GhimirePlan/Project_AuraSync/Documentations/AuraSync_Final_Defense.pdf

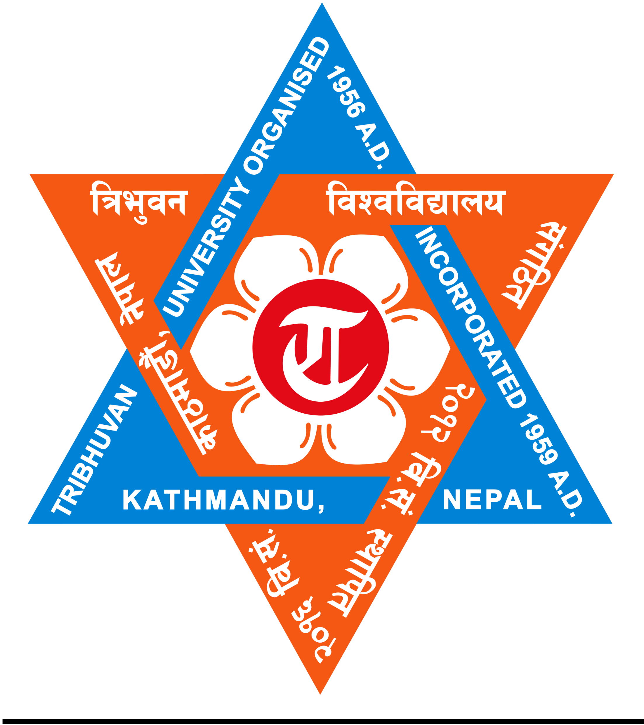
[picture p2: figure]

### Department of Electronics and Computer Engineering

### Institute of Engineering, Thapathali Campus

## A PRIVACY-PRESERVING EDGE TINYML SYSTEM FOR ACOUSTIC COMFORT ESTIMATION USING HYBRID DSP-CNN FUSION AND VISUAL FEEDBACK

## Team Members:

Plan Ghimire (080BEI028)
Pranjal Shrestha (080BEI033) Sagun Acharya (080BEI037)

Samman Ghale (080BEI039)

## Supervised By:

Dr. Binod Sapkota

Final Defense Presentation | August, 2026

# Presentation Outline

## 1. Motivation and Problem

## 2. Objectives

## 3. Scope and Applications

## 4. Literature Review

## 5. System Methodology

## 6. TinyML Development

## 7. Results and Validation

## 8. Privacy Boundary

## 9. Future Enhancements

## 10. Conclusion

August, 2026 | 2

# Motivation: Acoustic Comfort Needs Intelligence

## Current problem

### - Conversations and activities increase

noise.

### - Sound meters need people to keep

checking them.

### - Loud alarms can disturb the

environment further.

### - Direct warnings can make people feel

uncomfortable.

## Proposed response

- Monitor the sound level continuously.

### - Identify speech and other noise

activities.
- Give simple and calm visual feedback.

### - Help people control their noise

naturally.

### SENSE −→ INTERPRET −→ RESPOND

Goal: self-regulating shared spaces through objective visual feedback.

# Objectives

## Main Objective

## Design, develop, and validate a privacy-preserving edge acoustic-comfort

indicator using hybrid digital signal processing and embedded deep learning.

## Secondary Objectives

- Measure ambient sound levels and extract acoustic features in real time.

## - Classify stationary background, speech-dominant, and non-speech activity

using a TinyML CNN.
- Fuse deterministic DSP metrics with probabilistic model predictions.
- Provide adaptive visual feedback and anonymous dashboard analytics.

# Scope and System Boundary

## Included

## - Capture sound at 16 kHz

## - Measure sound level and key features

## - Classify sounds using INT8

## DS-CNN

## - Combine results to determine noise state

- Show feedback on TFT, LEDs,

## and dashboard

## Boundaries

- Raw audio is never stored or sent.

## - The prototype is an acoustic-comfort indicator, not a

certified legal sound-level meter.

## - Dashboard needs a local Wi-Fi

connection.

## - Secure MQTT communication is

future work.

# Project Applications

01
Classrooms

02
Libraries

03
Study rooms

04
Laboratories

05
Shared offices

06
Collaborative zones

# Literature Review and Research Gap

Prior work | Approach | Key finding | Gap addressed
IoT noise monitoring | dBA sensing and Wi-Fi dashboard | Live monitoring and logging | Adds sound-type awareness and local intelligence
TinyML anomaly detection | On-device inference | Low latency and low power | Adds stable and interpretable comfort states
Irrelevant-speech studies | Laboratory cognition experiments | Speech increases cognitive ef- fort | Converts findings into practical feedback
Large-scale audio CNNs | YAMNet/AudioSet classification | Strong audio representations | Distills knowledge into an MCU- ready DS-CNN

## Research Gap

Prior systems rarely combine calibrated DSP, TinyML classification, stable state logic, local privacy, and visual feedback in one low-cost embedded device.

# Methodology - [1] Overall System Block Diagram

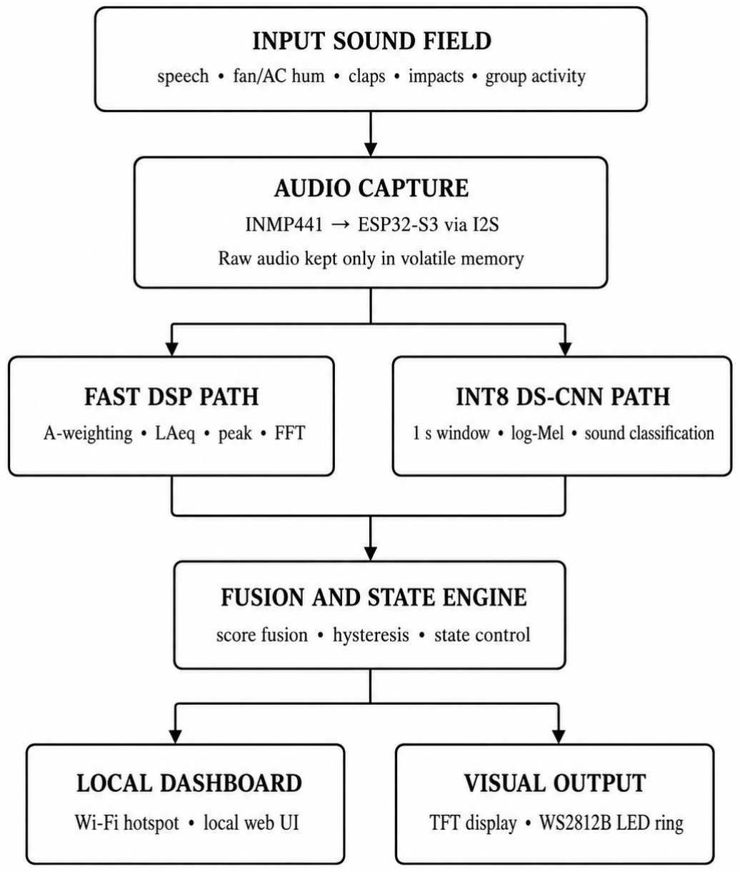
[picture p3: figure]

# Methodology - [2] Core Hardware Components

## ESP32-S3 N16R8

Core: dual-core 240 MHz Xtensa LX7.

### Memory: 16 MB flash and 8 MB

PSRAM.
Role: real-time DSP, INT8 inference, state control, display, and web service.

## INMP441 I2S MEMS Microphone

### Type: omnidirectional 24-bit digital

microphone.
Interface: I2S digital audio.

### Role: 16 kHz mono capture without an

analog conversion stage.

## Why this pair?

### Digital I2S acquisition reduces analog noise, while the ESP32-S3 provides enough

compute and memory for parallel DSP, TinyML, and local visualization.

# Methodology - [3] Feedback and Power Hardware

## 1.8-inch TFT SPI Display

Interface: high-speed SPI.
Role: displays live disturbance state, dBA level, score, and system status.

## WS2812B RGB LED Strip

Type: individually addressable LEDs.

### Role: immediate ambient feedback through state-specific colors and ani-

mations.

## Supporting hardware

### - TP4056 charging/protection module - 18650 Li-ion battery supply

## Physical integration

### - Compact 3D enclosure - Separated sensor/display placement

# Methodology - [4] Firmware and On-Device Software

### Firmware and execution

### - Arduino IDE and ESP32 toolchain

### - FreeRTOS tasks and dual-core scheduling

### - I2S DMA audio acquisition

### - Ucglib TFT rendering and LED control

### On-device processing

### - ESP-DSP FFT and biquad filtering

### - TensorFlow Lite for Microcontrollers

### - Fully quantized INT8 inference

### - Local HTTP/JSON status service

## Scheduling principle

### Fast DSP updates every 100 ms; one-second CNN inference does not block the feedback

loop.

# Methodology - [5] Offline AI and Dashboard

# Stack

### Offline AI pipeline

### - Python, TensorFlow, Keras, and Librosa

### - Audio preprocessing and embeddings

### - Teacher-student knowledge distillation

### - DS-CNN training and INT8

### quantization

### Visualization

### - HTML5 Canvas and JavaScript

### - Board-hosted responsive dashboard

### - Asynchronous HTTP polling

### - Anonymous scalar metrics only

Training occurs offline; operational inference occurs entirely on the edge device.

# Methodology - [6] Audio Capture and DSP

# Pipeline

### - 16 kHz mono audio capture

using INMP441 and I2S DMA.

### - Temporary PCM storage in an

SRAM ring buffer.

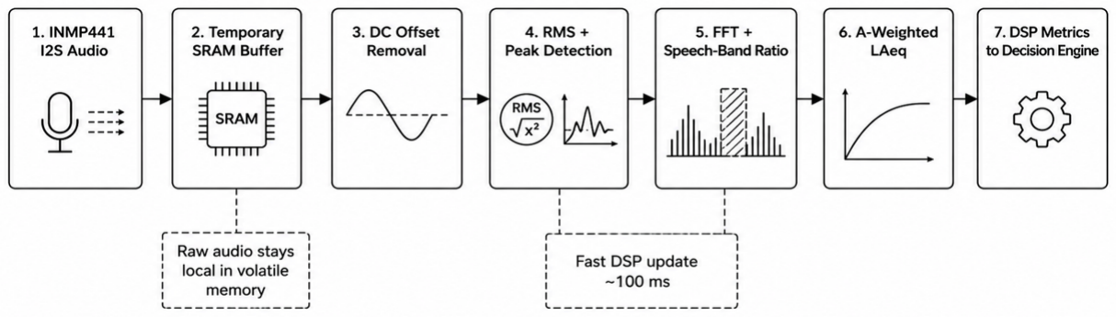
[picture p4: figure]

- DC offset removal, windowing, RMS and peak calculation.

### - FFT analysis for speech-band

ratio and spectral flux.

### - A-weighting and calibration for

LAeq estimation.

# Methodology - [7] Fast DSP Path

## Update cadence

100 ms

### 1,600 samples per block at 16 kHz

## Physical acoustic features - A-weighted LAeq

## - Peak, RMS, and crest factor

## - 256-point FFT

## - Speech-band energy ratio

## - Spectral flux and spike evidence

Purpose: fast, deterministic reaction to loudness and transient events.

# Methodology - [8] Log-Mel and TinyML Path

## Inference window

# 1 s

### 16,000 samples, updated continuously

## Feature tensor construction - 512-point FFT with 320-sample hop

## - 64 Mel filter-bank channels

## - Log compression and normalization

## - 49 × 64 × 1 input tensor

## - Three-class INT8 DS-CNN inference

Purpose: identify acoustic context that loudness alone cannot explain.

# Methodology - [9] Teacher-Student Model Training

## 1. Transfer learning

### - Reuse a model trained on a large audio

dataset.

### - Adapt learned representations to

three project classes.

## 2. YAMNet teacher

### - Frozen MobileNetV1-based

audio classifier.

### - Produces 1,024-D embeddings and soft

targets.

## 3. DS-CNN student

- Fast and lightweight;

### optimized for

microcontrollers.

### - Uses depthwise separable

convolutions.

## Knowledge Distillation

YAMNet is too large for microcontrollers. Knowledge Distillation trains a compact Student model to match the soft probability outputs of a heavy Teacher model. This compresses deep-learning intelligence so it can run directly on the ESP32-S3.

# Methodology - [10] Teacher-Student DS-CNN Architecture

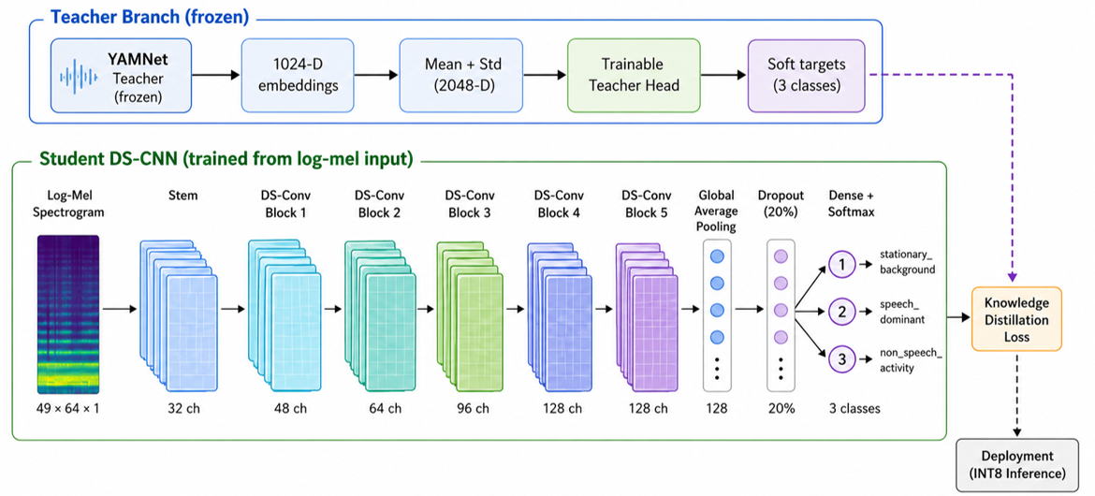
[picture p5: figure]

### - Multiple student configurations were evaluated during training; the model with the

lowest Knowledge Distillation loss was deployed on the ESP32-S3.

# Methodology - [11] Dataset Overview

## Dataset preparation

## - Collected 12,466 environmental audio clips

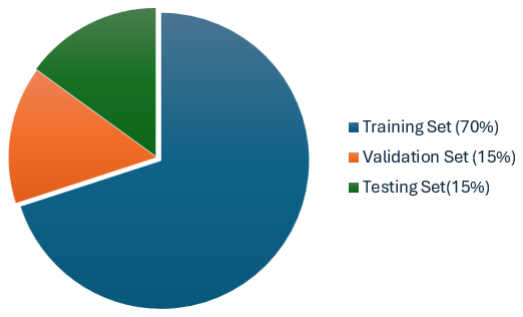
[picture p6: figure]

## - Each clip is 1 second long, sampled at 16

## kHz

## Three audio classes:

## - Stationary Background

### (fan, AC, computer hum, quiet room)

## - Speech Dominant

### (conversations, discussions, lectures)

## - Non-Speech Activity

### (typing, footsteps, coughing, clapping)

## Dataset Split

# Methodology - [12] Fused Disturbance Score

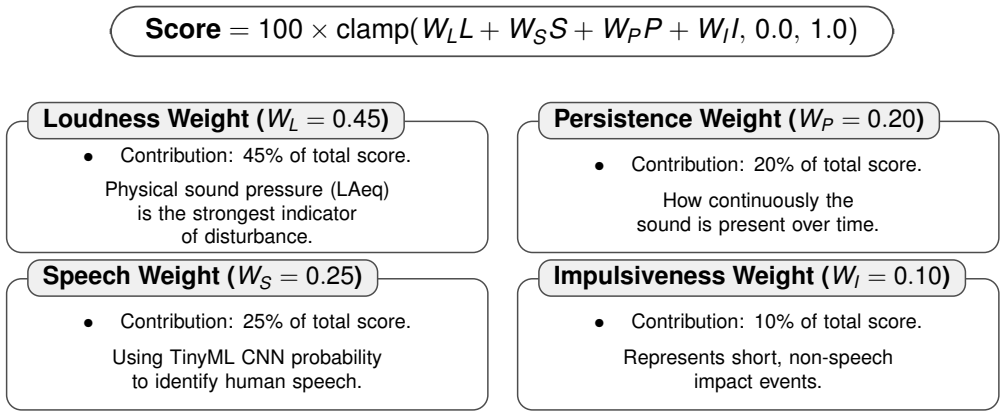
[picture p7: figure]
Loudness Weight (WL = 0.45); • Contribution: 45% of total score.; Physical sound pressure (LAeq) is the strongest indicator of disturbance.; Persistence Weight (WP = 0.20); • Contribution: 20% of total score.; How continuously the sound is present over time.; Speech Weight (WS = 0.25); • Contribution: 25% of total score.; Using TinyML CNN probability to identify human speech.; Impulsiveness Weight (WI = 0.10); • Contribution: 10% of total score.; Represents short, non-speech impact events.

## Score = 100 × clamp(WLL + WSS + WPP + WI

# Methodology - [13] State Machine Architecture

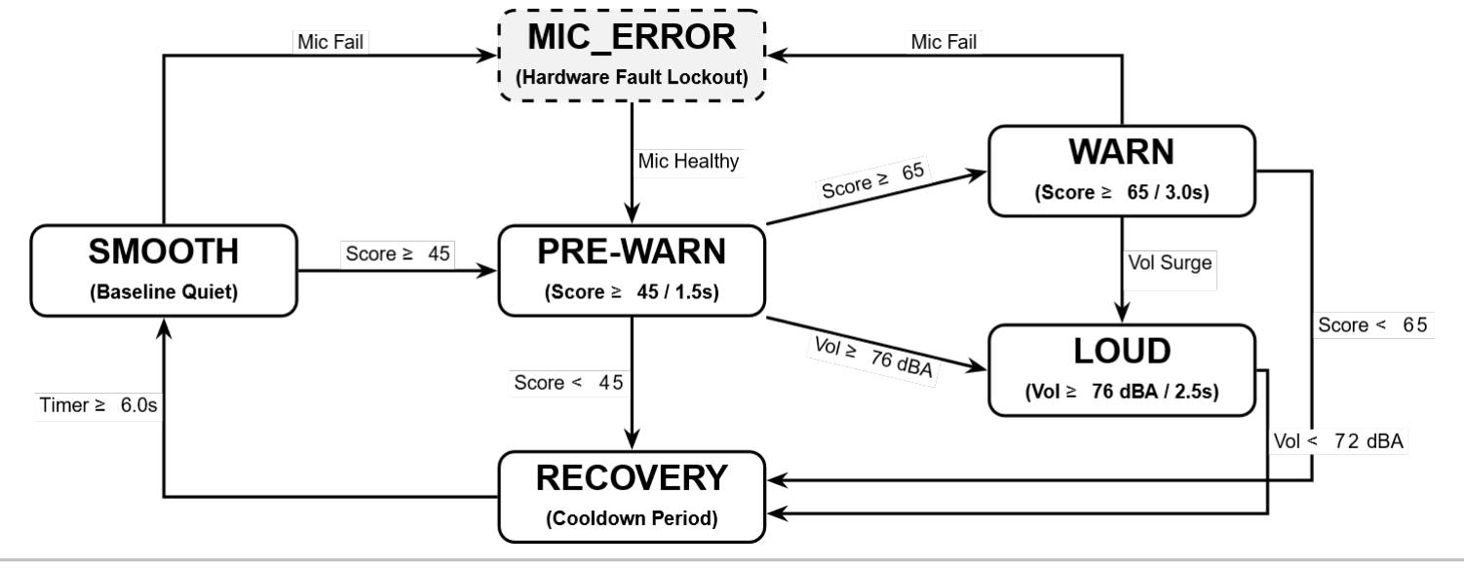
[picture p8: figure]

State & Threshold Calibration :
- 4 states: SMOOTH → PRE-WARNING → WARNING → LOUD
- Thresholds are tested using measured audio and reference sound-level meter.
- ISO 22955:2021 / ANSI/ASA S12.60 used as acoustic-comfort references.
- Thresholds tuned for stable transitions and fewer false alarms.

# Results - [1] Model Performance

### Test Set Confusion Matrix Comparison (1,876 Samples)

Float32 Baseline (Before)

True \ Pred | BG | Speech | Non-Sp
Background | 323 | 3 | 89
Speech | 4 | 492 | 16
Non-Speech | 68 | 12 | 869

Full INT8 Model (Deployed)

True \ Pred | BG | Speech | Non-Sp
Background | 324 | 4 | 87
Speech | 4 | 493 | 15
Non-Speech | 69 | 12 | 868

## Quantization Impact

Full INT8 post-training quantization preserves decision boundaries across all three classes with negligible impact on accuracy (89.77% → 89.82%) while reducing model memory footprint to 75.6 KiB.

# Results - [2] Local Web Dashboard

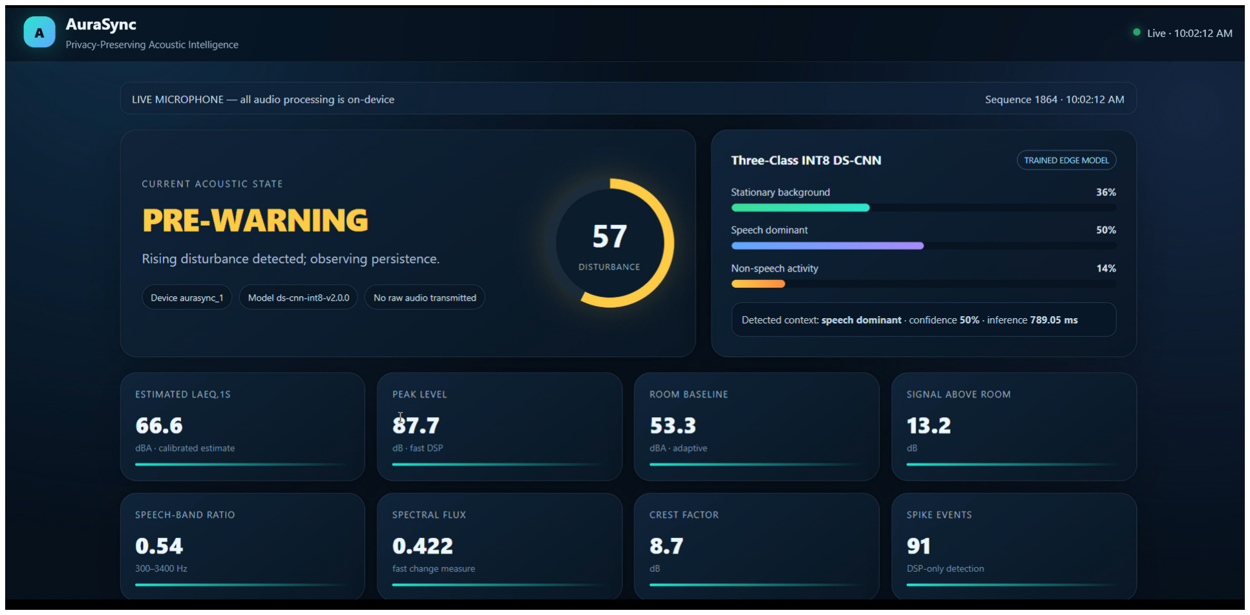
[picture p9: figure]

Live state, score, class probabilities, calibrated level, baseline, and diagnostics.

# Results - [3] Integrated Prototype

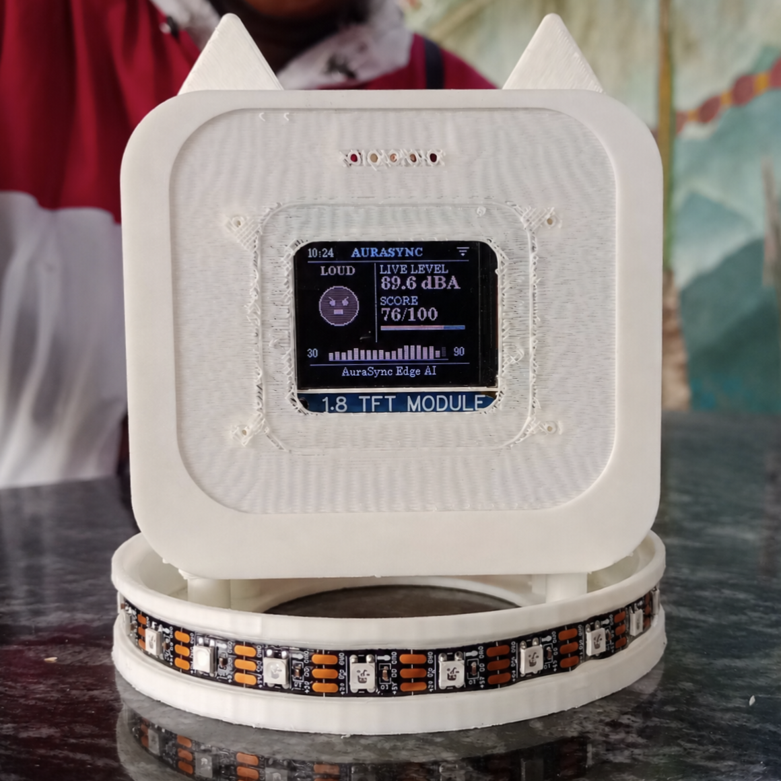
[picture p10: figure]

## Integrated functions

### - I2S capture

### - DSP and INT8 CNN - TFT state display - RGB feedback

### - Local dashboard

# Validation - [1] Test Scenarios

ID | Scenario | Range | Target | Expected
VAL-01 | Standard conversation | 58–66 dBA | speech dominant | WARNING
VAL-02 | Quiet study | < 50 dBA | background | SMOOTH
VAL-03 | AC / ceiling fan | 52–56 dBA | background | SMOOTH/PRE-WARNING
VAL-04 | Clap / object drop | ≥ 78 dB peak | DSP spike | SPIKE
VAL-05 | Group shouting | ≥ 76 dBA | DSP loud | LOUD
VAL-06 | Speech stops | < 53 dBA | background | RECOVERY

## Validation purpose

## Verify that physical level, detected class, fused score, temporal logic, and final

visual state remain consistent under representative acoustic conditions.

# Validation - [2] Measured Data

Scenario | LAeq | Peak | Score | Final state
Conversation | 73.4 | 90.8 | 68 | LOUD
Quiet baseline | 43.1 | 49.8 | 34 | SMOOTH
Fan | 53.8 | 59.8 | 49 | PRE-WARNING
Handclap / spike | 55.2 | 82.4 | 22 | SPIKE
Speech stops | 46.2 | 52.8 | 10 | RECOVERY

### Observed class outputs

### - Speech dominant

### - Stationary background

### - Non-speech activity

### Calibration check

### - Tested from 50 to 80 dBA

### - Maximum absolute error: approximately 0.4 dB

# Validation - [3] State Logic Matched Expectations

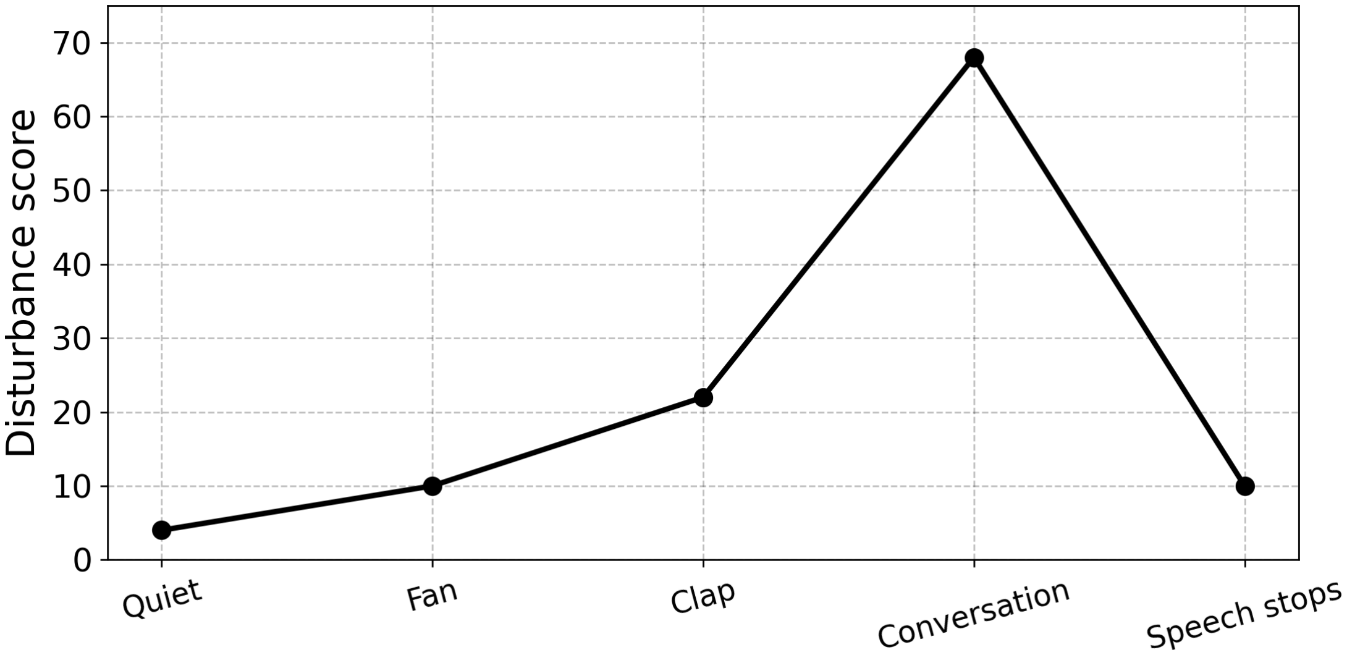
[picture p11: figure]

### - Conversation produced

WARNING.

### - Quiet and fan remained

SMOOTH.

### - Clap produced the SPIKE

overlay.

### - Speech stopping triggered

RECOVERY.

### - Observed logic matched

expected states.

# Privacy-by-Design Boundary

### INMP441

Raw PCM
↓

### Volatile RAM

Short buffers
↓

### DSP + INT8 CNN

Features and inference
↓

### Local HTTP API

Anonymous scalar metrics

## Privacy guarantee

### Audio is processed locally on the ESP32-S3. Raw buffers are

overwritten and never written to flash, SD storage, or the network.

### - No conversation recordings

### - No raw-audio upload endpoint

- Only class probabilities, levels,

### states, and diagnostics are exposed

# Future Enhancements

## - Develop a dedicated PCB and compact enclosure with improved acoustic

isolation.
- Add adaptive room calibration and automatic threshold adjustment.
- Expand the dataset with diverse Nepalese classroom and office recordings.

## - Add more acoustic classes, secure MQTT telemetry, and multi-device

monitoring.
- Develop a companion mobile application and secure over-the-air updates.
- Pursue standardized acoustic testing and Class 2 sound-level certification.

# Conclusion

# 75.6 KiB

deployed INT8 model

89.82%

test accuracy

46,867

model parameters

100 ms

fusion update period

- Project runs real-time acoustic analysis locally on an ESP32-S3.
- Hybrid DSP and TinyML separate physical loudness from acoustic context.
- Temporal logic provides stable, non-judgmental visual feedback.
- The design avoids raw-audio retention and transmission by default.
- Prototype, dashboard, calibration, and scenario tests demonstrate feasibility.

# References I

[1] W. Ellermeier and K. Zimmer, “Individual differences in susceptibility to the irrelevant speech effect,” J. Acoust. Soc. Am., vol. 102, no. 5, pp. 2685–2691, Nov. 1997.
[2] M. Haka, A. Haapakangas, J. Keranen, J. Hakala, E. Keskinen, and V. Hongisto, “Performance effects and subjective disturbance of speech in acoustically different office types — a laboratory experiment,” Indoor Air, vol. 19, no. 6, pp. 454–467, 2009.
[3] J. Radun, J. Ljung, and V. Hongisto, “The effects of irrelevant speech on physiological stress, cognitive performance, and subjective experience — Focus on heart rate variability,” Int. J. Psychophysiol., vol. 200,
p. 112352, Apr. 2024.
[4] E. Lombard, “Le signe de l’elevation de la voix,” Ann. Mal. de l’Oreille, du Larynx, du Nez et du Pharynx, vol. 37, pp. 101–119, 1911.
[5] P. Bottalico, I. I. Passione, S. Graetzer, and E. J. Hunter, “Evaluation of the starting point of the Lombard effect,” Acta Acust. united with Acust., vol. 103, no. 1, pp. 169–172, 2017.

# References II

[6] P. Bottalico, R. N. Piper, and B. Legner, “Lombard effect, intelligibility, ambient noise, and willingness to spend time and money in a restaurant amongst older adults,” Sci. Rep., vol. 12, no. 1, p. 6549, 2022.
[7] Acoustics — Acoustic quality of open office spaces, ISO Standard 22955:2021, 2021.
[8] American National Standard Acoustical Performance Criteria, Design Requirements, and Guidelines for Schools, Part 1: Permanent Schools, ANSI/ASA S12.60-2010/Part 1, 2010.
[9] K. S. Pearsons, R. L. Bennett, and S. Fidell, “Speech levels in various environments,” U.S. Environmental Protection Agency, Washington, D.C., USA, Tech. Rep. EPA-600/1-77-025, May 1977.
[10] A. N. Rimell, N. J. Mansfield, and G. S. Paddan, “Design of digital filters for frequency weightings required for risk assessments of workers exposed to noise,” Ind. Health, vol. 53, no. 1, pp. 21–27, 2015.
[11] J. W. Cooley and J. W. Tukey, “An algorithm for the machine calculation of complex Fourier series,” Math. Comput., vol. 19, no. 90, pp. 297–301, Apr. 1965.

# References III

[12] J. Ramirez, J. M. Gorriz, and J. C. Segura, “Voice Activity Detection: Fundamentals and Speech Recognition System Robustness,” in Robust Speech Recognition and Understanding, M. Grimm and K. Kroschel, Eds. Vienna, Austria: I-Tech, 2007, ch. 1, pp. 1–22.
[13] S. Hershey et al., “CNN architectures for large-scale audio classification,” in Proc. IEEE Int. Conf. Acoust., Speech Signal Process. (ICASSP), New Orleans, LA, USA, 2017, pp. 131–135.
[14] G. Marques and R. Pitarma, “A real-time noise monitoring system based on IoT for enhanced acoustic comfort and occupational health,” IEEE Access, vol. 8, pp. 13974–13985, 2020.
[15] M. Hammad, A. M. Al-Masri, M. Al-Hammadi, and B. S. Al-Radaideh, “An unsupervised TinyML approach to detection of urban noise anomalies,” Internet of Things, vol. 22, p. 100723, 2023.
[16] G. Cerutti, R. Prasad, A. Brutti, and E. Farella, “Compact recurrent neural networks for acoustic event detection on low-energy low-complexity platforms,” IEEE J. Sel. Topics Signal Process., vol. 14, no. 4, pp. 786–797, May 2020.
[17] P. Warden and D. Situnayake, TinyML: Machine Learning with TensorFlow Lite on Arduino and Ultra-Low-Power Microcontrollers, 1st ed. Sebastopol, CA, USA: O’Reilly Media, 2019.

# References IV

[18] Espressif Systems, ESP-DL: Deep Learning Library for Espressif SoCs, 2023. [Online]. Available: https://github.com/espressif/esp-dl.
[19] M. F. Usmani, “MQTT Protocol for the IoT — Review Paper,” Int. J. Comput. Appl., vol. 183, no. 39, pp. 17–22, Jun. 2021.
[20] N. Radwan and J. Alves-Foss, “MQTT in focus: Understanding the protocol and its recent advancements,” 2024.
[21] S. S. Gill et al., “Edge AI: A taxonomy, systematic review and future directions,” Cluster Comput., vol. 28, no. 1, p. 18, 2025.

# THANK YOU!

# Questions and Discussion

### Privacy-Preserving Acoustic Intelligence at the Edge

# APPENDIX

# Technical Architecture and Implementation

### Supplementary Material for Defense Q&A

# Appendix – DS-CNN Architecture

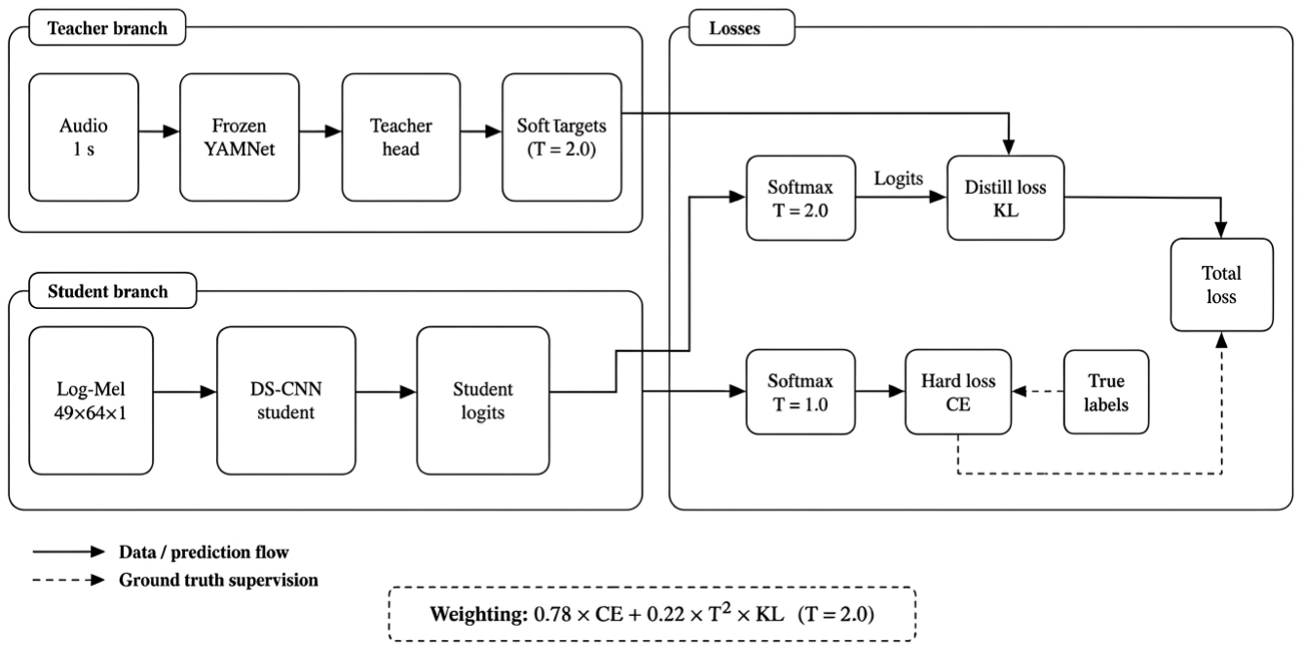
[picture p12: figure]

# Appendix – Acoustic State Machine

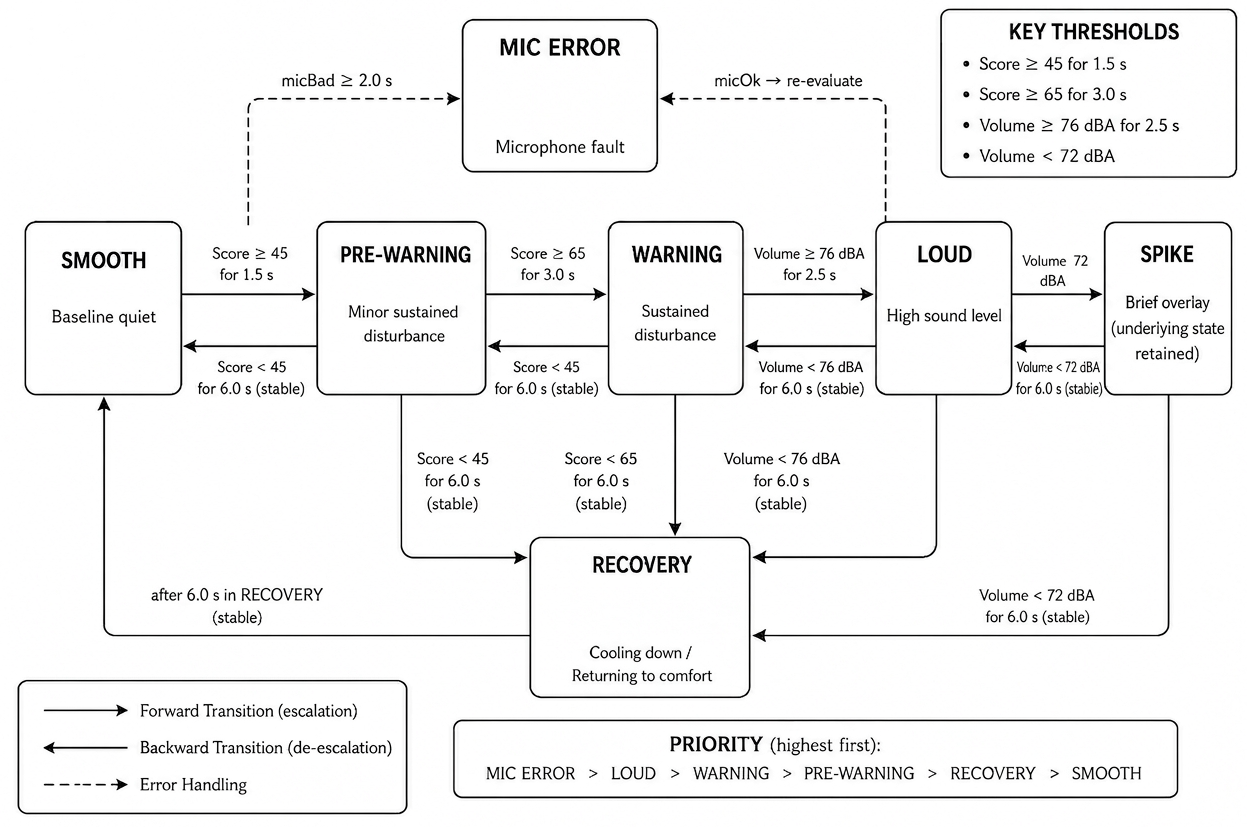
[picture p13: figure]

# Appendix – State Transition Timing

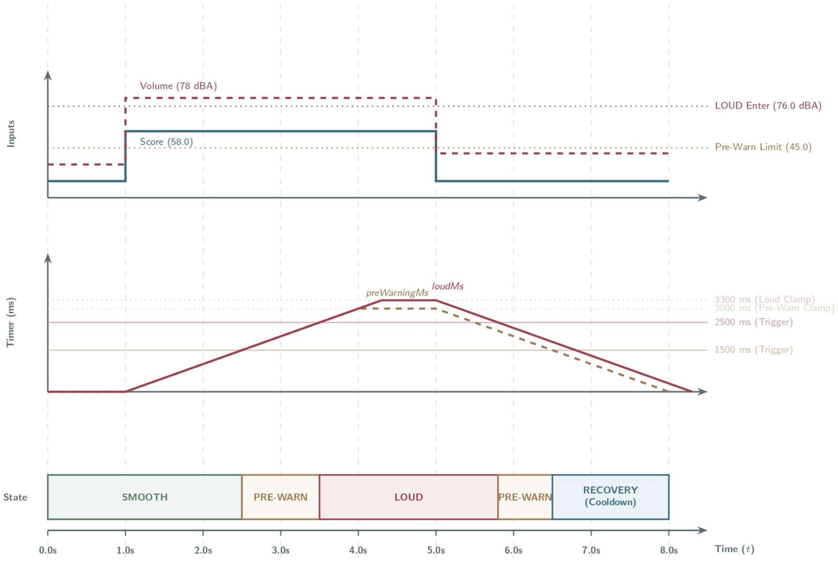
[picture p14: figure]
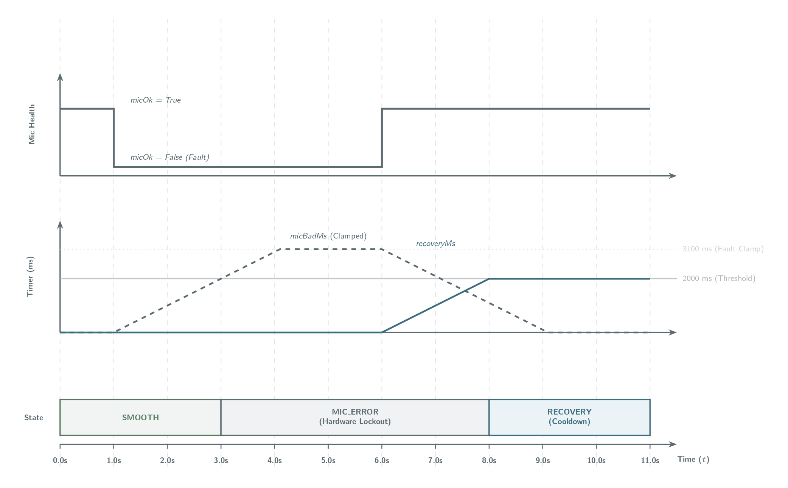
[picture p15: figure]
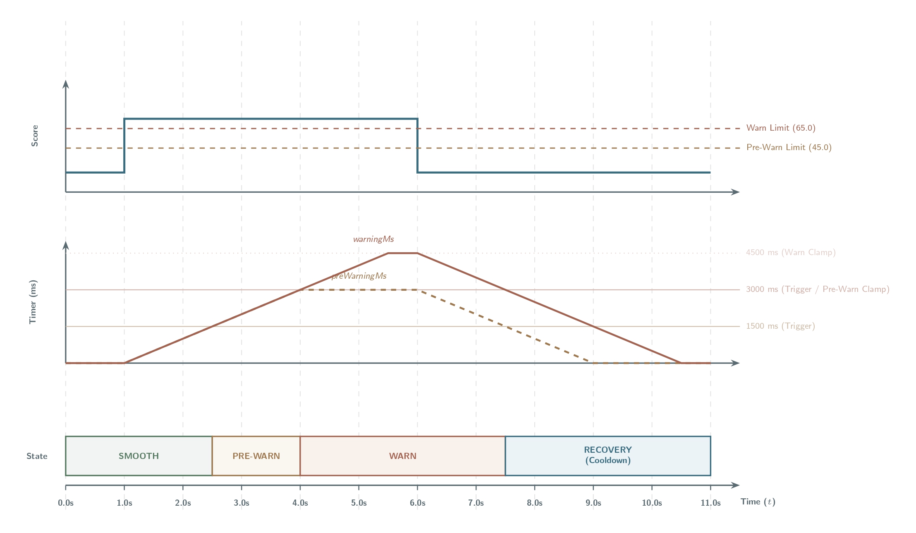
[picture p16: figure]

LOUD State Response | Mic Fault / Error Handling | Warning / Pre-Warning

# Appendix – Privacy-Preserving Architecture

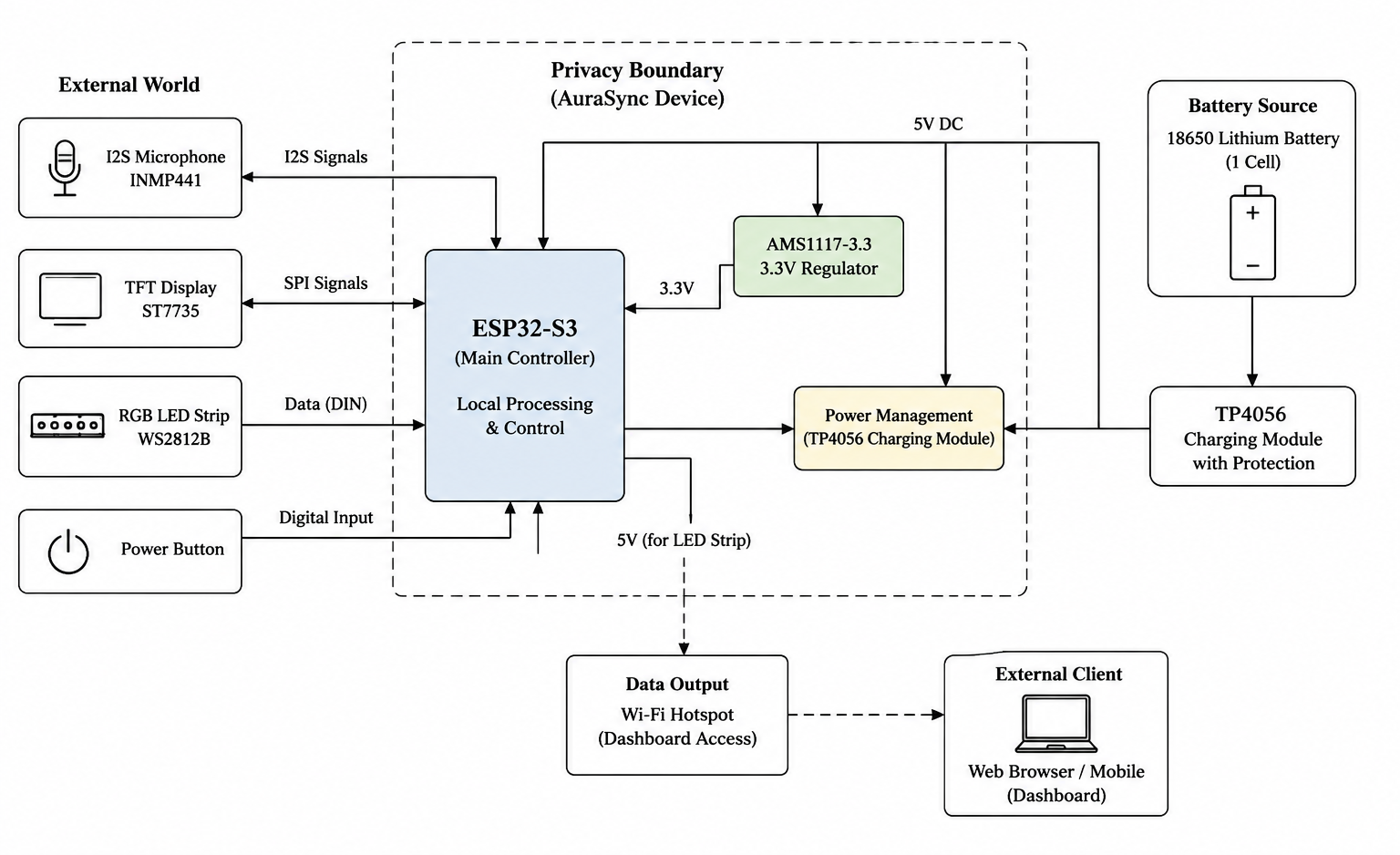
[picture p17: figure]

# Appendix – Circuit Diagram

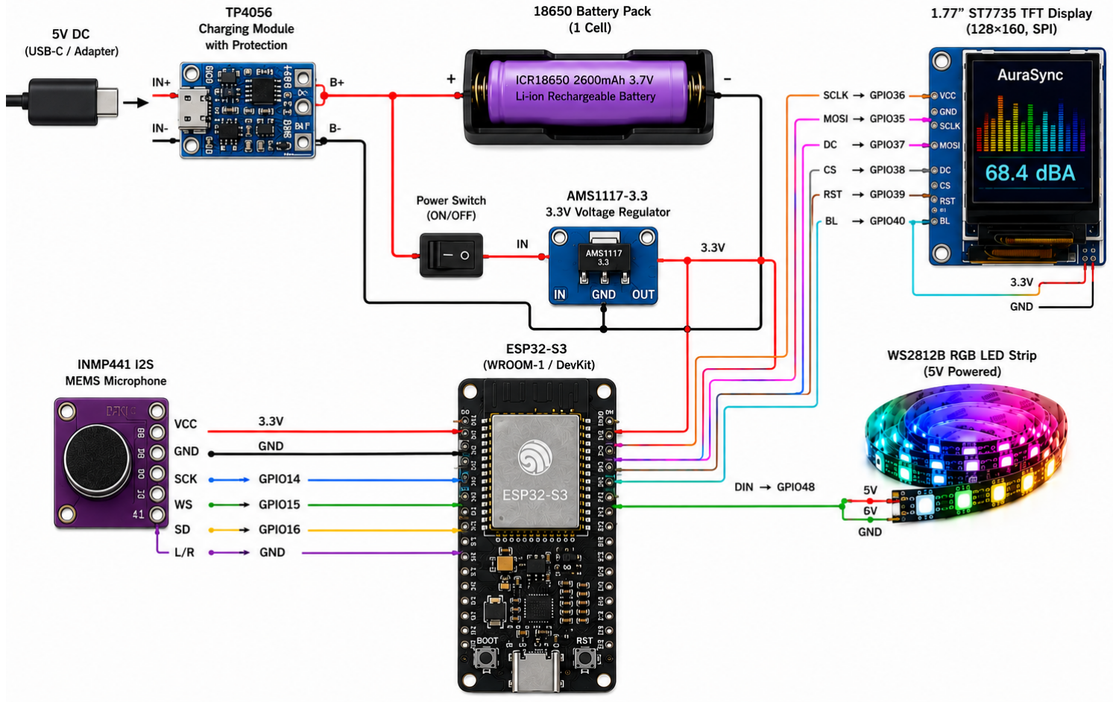
[picture p18: figure]
