GhimirePlan/Project_AuraSync/AS_DL_Model/Deployed_Package & Training_Logs/dataset_class_balance.png

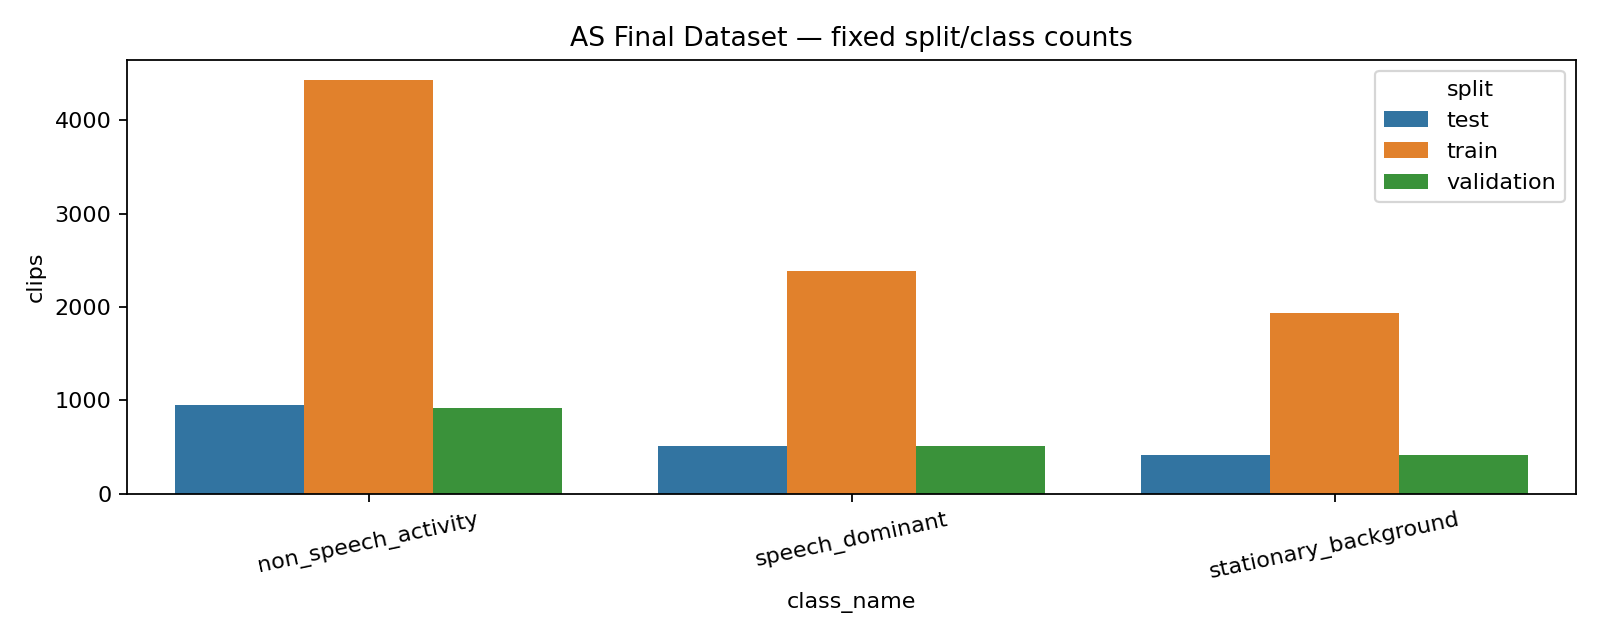
AS_DL_Model/Deployed_Package & Training_Logs/dataset_class_balance.png
