GhimirePlan/Project_AuraSync/AS_DL_Model/Deployed_Package & Training_Logs/float_confusion_matrix.png

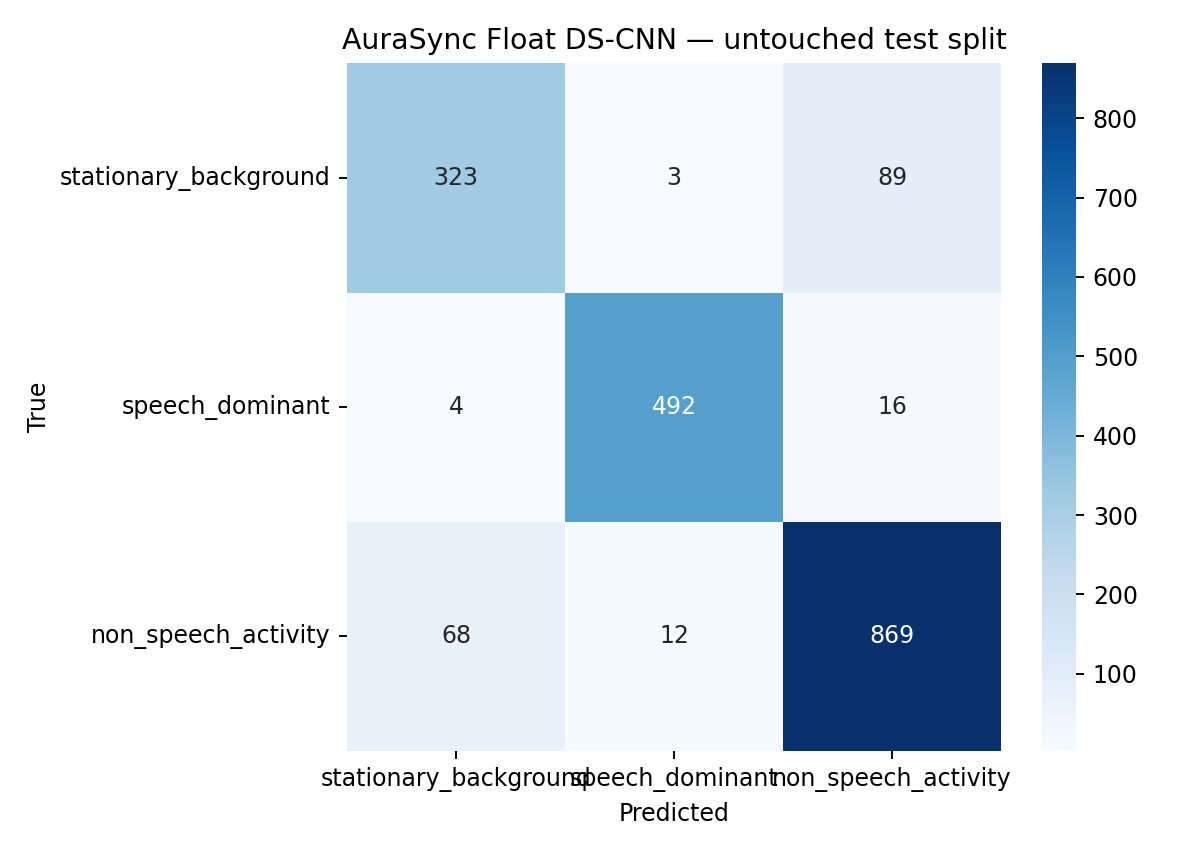
AS_DL_Model/Deployed_Package & Training_Logs/float_confusion_matrix.png
