GhimirePlan/Project_AuraSync/AS_DL_Model/Deployed_Package & Training_Logs/student_candidate_results.csv

run | seed | val_accuracy | val_macro_f1 | epochs_ran
1 | 20260713 | 0.9326086956521739 | 0.928880136197786 | 45
2 | 1729 | 0.9315217391304348 | 0.9271298292892428 | 67
