GhimirePlan/Project_AuraSync/AS_DL_Model/Deployed_Package & Training_Logs/validation_confidence_thresholds.csv

threshold | coverage | accuracy_when_accepted
0.34 | 1.0 | 0.9326086956521739
0.35000000000000003 | 1.0 | 0.9326086956521739
0.36000000000000004 | 1.0 | 0.9326086956521739
0.37000000000000005 | 1.0 | 0.9326086956521739
0.38000000000000006 | 0.9994565217391305 | 0.933115823817292
0.39000000000000007 | 0.9983695652173913 | 0.9335873707131193
0.4000000000000001 | 0.9978260869565218 | 0.9335511982570807
0.4100000000000001 | 0.9978260869565218 | 0.9335511982570807
0.4200000000000001 | 0.9972826086956522 | 0.9340599455040872
0.4300000000000001 | 0.996195652173913 | 0.9345335515548282
0.4400000000000001 | 0.9951086956521739 | 0.9355543418896778
0.4500000000000001 | 0.9945652173913043 | 0.9360655737704918
0.46000000000000013 | 0.9945652173913043 | 0.9360655737704918
0.47000000000000014 | 0.9934782608695653 | 0.9359956236323851
0.48000000000000015 | 0.9929347826086956 | 0.9359605911330049
0.49000000000000016 | 0.991304347826087 | 0.9369517543859649
0.5000000000000002 | 0.9902173913043478 | 0.9374313940724479
0.5100000000000002 | 0.9885869565217391 | 0.9378779549202859
0.5200000000000002 | 0.9864130434782609 | 0.9388429752066115
0.5300000000000002 | 0.9793478260869565 | 0.9406215316315205
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
