GhimirePlan/Project_AuraSync/AuraSync_Firmware/aurasync_preprocessing_params.h

#pragma once
#include <cstdint>

constexpr int AURASYNC_SAMPLE_RATE = 16000;
constexpr int AURASYNC_TARGET_SAMPLES = 16000;
constexpr int AURASYNC_N_FFT = 512;
constexpr int AURASYNC_WIN_LENGTH = 512;
constexpr int AURASYNC_HOP_LENGTH = 320;
constexpr int AURASYNC_TIME_FRAMES = 49;
constexpr int AURASYNC_N_MELS = 64;
constexpr int AURASYNC_CLASS_COUNT = 3;
constexpr float AURASYNC_FMIN = 80.0f;
constexpr float AURASYNC_FMAX = 7600.0f;
constexpr float AURASYNC_LOG_EPS = 1e-06f;
constexpr bool AURASYNC_APPLY_CLIP_MEAN_NORMALIZATION = true;
constexpr float AURASYNC_INPUT_SCALE = 0.0420644507f;
constexpr int AURASYNC_INPUT_ZERO_POINT = -33;
constexpr float AURASYNC_OUTPUT_SCALE = 0.00390625f;
constexpr int AURASYNC_OUTPUT_ZERO_POINT = -128;
constexpr float AURASYNC_LIVE_CONFIDENCE_THRESHOLD = 0.3400f;

const char* AURASYNC_LABELS[AURASYNC_CLASS_COUNT] = {
  "stationary_background",
  "speech_dominant",
  "non_speech_activity",
};

const float AURASYNC_MEL_MEAN[AURASYNC_N_MELS] = {
  2.85985398f, 2.54039621f, 2.60087395f, 2.39089203f, 2.1577816f, 2.20623946f, 1.93826067f, 2.09998822f, 1.85889244f, 1.84227204f, 1.75535572f, 1.51904082f, 1.63319266f, 1.30762362f, 1.42767322f, 1.26418662f, 1.19188631f, 1.17332864f, 0.876866162f, 1.0146451f, 0.696325064f, 0.817176521f, 0.612081468f, 0.593285918f, 0.538715184f, 0.421838552f, 0.370433748f, 0.314743996f, 0.26561439f, 0.250262022f, 0.159169257f, 0.10512647f, 0.0487680063f, -0.0305292048f, -0.0948577896f, -0.139668882f, -0.233494699f, -0.36966297f, -0.425881714f, -0.509365499f, -0.560060441f, -0.667850316f, -0.751394928f, -0.834241271f, -0.957810104f, -1.05654883f, -1.11460912f, -1.16782868f, -1.2515229f, -1.36702299f, -1.41465259f, -1.5081563f, -1.65665555f, -1.76001835f, -1.87739956f, -1.99976182f, -2.09452868f, -2.19064832f, -2.27485085f, -2.28320646f, -2.34901786f, -2.48488975f, -2.62514138f, -2.80328631f,
};

const float AURASYNC_MEL_STD[AURASYNC_N_MELS] = {
  3.64070034f, 3.5091095f, 3.4199307f, 3.31005216f, 3.2038312f, 3.1895268f, 3.19851351f, 3.19722962f, 3.14851046f, 3.09954286f, 3.04664874f, 2.995924f, 2.97262549f, 2.90971899f, 2.87623024f, 2.83300424f, 2.8228941f, 2.80367398f, 2.74021029f, 2.71001267f, 2.67261314f, 2.65303755f, 2.61436343f, 2.61179495f, 2.60930037f, 2.57415295f, 2.54125023f, 2.51227331f, 2.49229527f, 2.47008562f, 2.43170547f, 2.42446899f, 2.4164629f, 2.39727783f, 2.4086113f, 2.50100827f, 2.47608876f, 2.36993861f, 2.36566854f, 2.3730762f, 2.38866496f, 2.40050006f, 2.37294197f, 2.34266782f, 2.32889915f, 2.32330871f, 2.34948015f, 2.40342498f, 2.40688872f, 2.38785243f, 2.52685356f, 2.52689528f, 2.40318084f, 2.37804055f, 2.33860421f, 2.3339808f, 2.34455514f, 2.34472084f, 2.36934233f, 2.51553226f, 2.53749299f, 2.42404294f, 2.39532924f, 2.3822422f,
};
