GhimirePlan/Project_AuraSync/(commit log)

2026-07-18 implemented dataset extraction and integrity auditing
    [archive_audit.csv, repository_dataset_manifest.csv]
2026-08-04 implemented candidate training and validation selection
    [student_candidate_results.csv, training_history_all_candidates.csv]
2026-08-13 implemented confidence tuning and deployment gating
    [validation_confidence_thresholds.csv]
2026-08-18 implemented browser microphone testing and reporting
    [live_microphone_test_result.csv]
2026-08-22 implemented firmware configuration and device defaults
2026-09-03 implemented microphone setup and sample capture
2026-09-22 implemented simulation controls and calibration persistence
2026-09-24 implemented device endpoints and route registration
2026-09-26 implemented wireless access and network discovery
2026-09-29 implemented device startup and service loop
2026-10-03 documented microphone connections and hardware wiring
2026-11-06 added prototype image to project readme
2026-11-06 Update README to reflect current project scope
    Removed outdated information about the July 2026 academic progress report and its capabilities.
